Lil-G-Robot/electronics/lil-G-electrical.kicad_pcb

## KiCad design lil-G-electrical.kicad_pcb (2025-05-02)

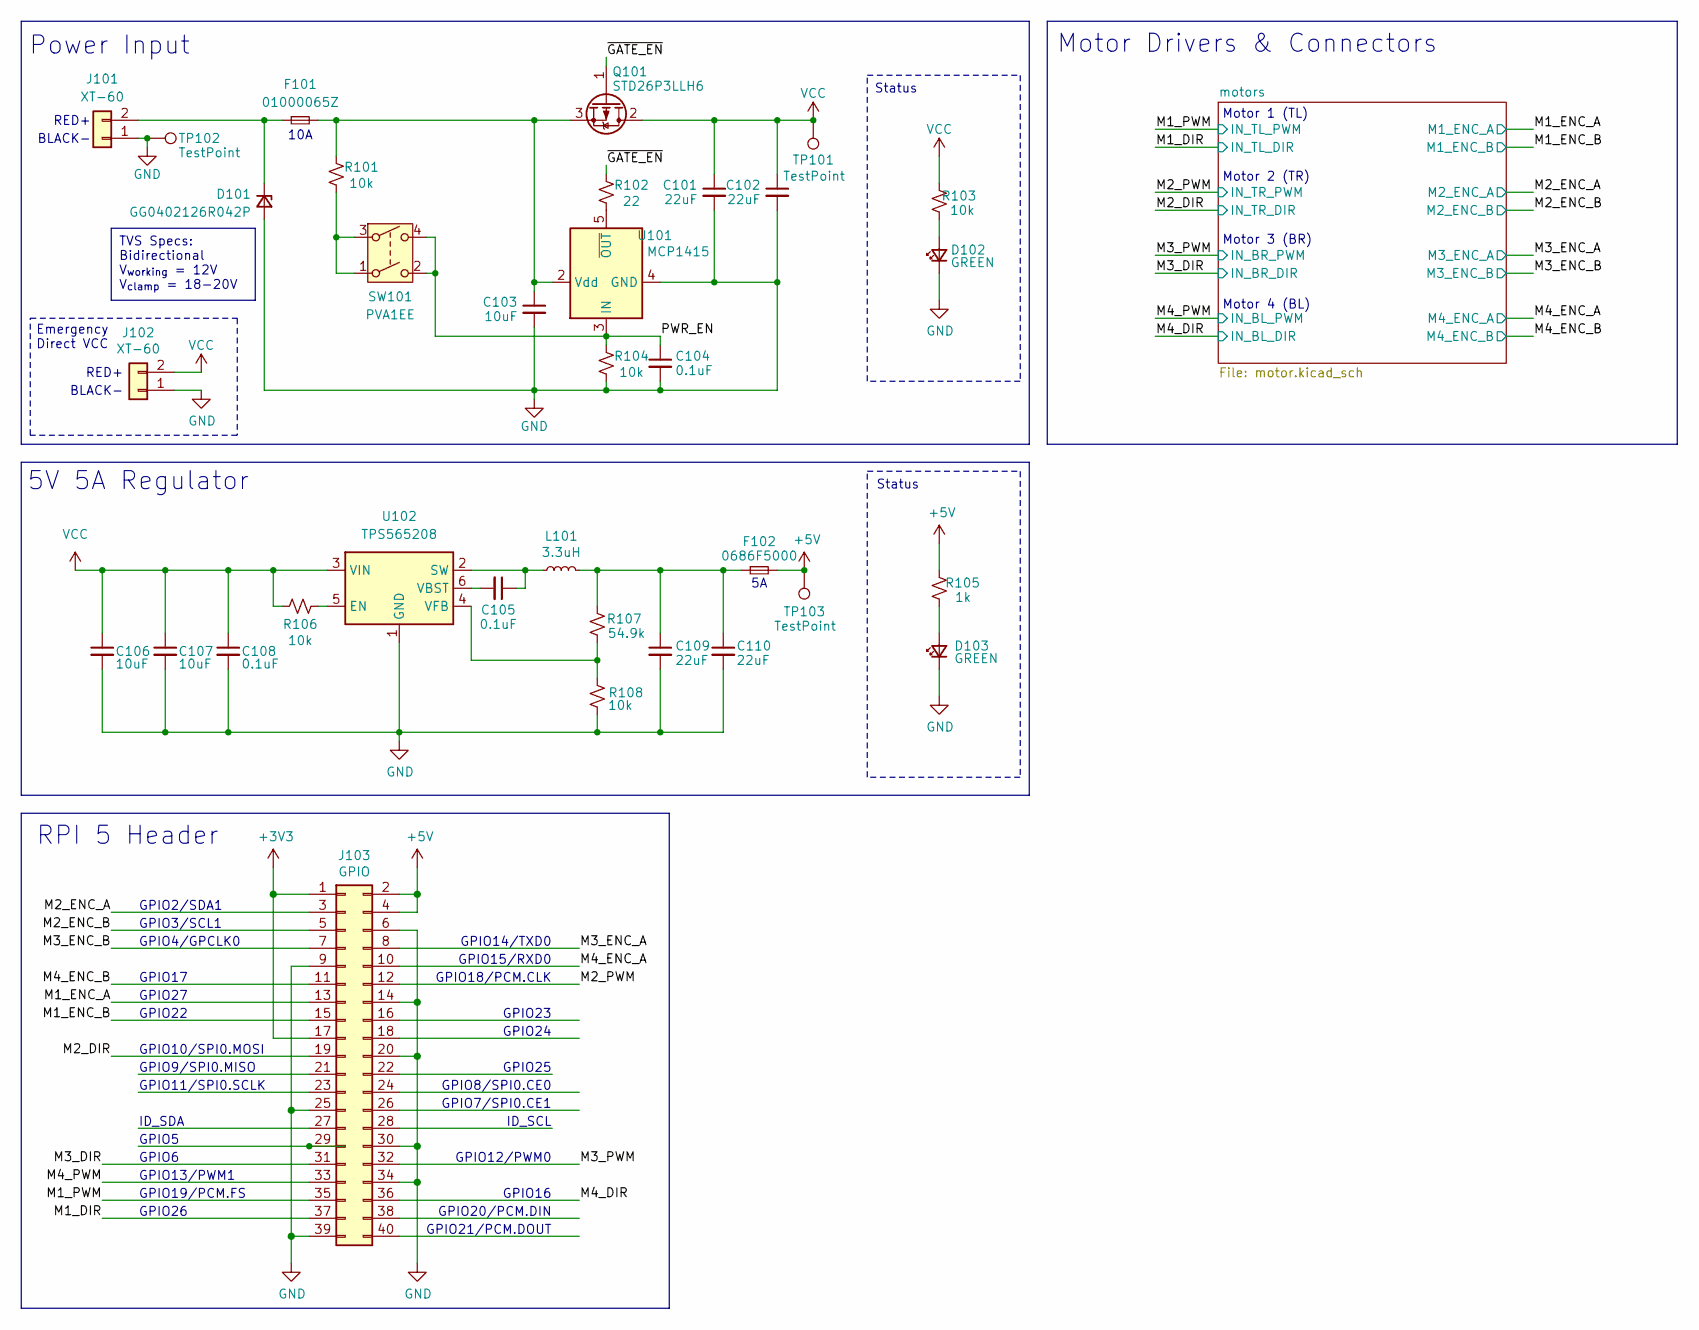
[picture p1: schematic lil-G-electrical.kicad_sch]

Parts:
C101, C102, C109, C110: 22uF; C_0805_2012Metric
C103, C106, C107: 10uF; C_0603_1608Metric
C104, C105, C108: 0.1uF; C_0603_1608Metric
D101: GG0402126R042P; D_0402_1005Metric
D102, D103: GREEN; LED_0603_1608Metric
F101: 01000065Z; LittleFuse_Mini_100_SMD
F102: 0686F5000; Fuse_0603_1608Metric; MPN F0603SB5000V032TM
J101, J102: XT-60; AMASS_XT60-M_1x02_P7.20mm_Vertical
J103: GPIO; PinSocket_2x20_P2.54mm_Vertical
L101: 3.3uH; L_Bourns_SRP5030T; MPN SRP5030T-3R3M
Q101: STD26P3LLH6; TO-252-2
R101, R103, R104, R106, R108: 10k; R_0603_1608Metric
R102: 22; R_0603_1608Metric
R105: 1k; R_0603_1608Metric
R107: 54.9k; R_0603_1608Metric
SW101: PVA1EE; SW_Push_2P1T_Toggle_CK_PVA1xxH4xxxxxxV2
TP101, TP102, TP103: TestPoint; TestPoint_Keystone_5000-5004_Miniature
U101: MCP1415; SOT-23-5
U102: TPS565208; SOT-23-6

Connections:
+3V3: J103.1, J103.17; also elsewhere on the board
+5V: F102.2, J103.2, J103.4, R105.2, TP103.1; also elsewhere on the board
/M1_DIR: J103.37; also elsewhere on the board
/M1_ENC_A: J103.13; also elsewhere on the board
/M1_ENC_B: J103.15; also elsewhere on the board
/M1_PWM: J103.35; also elsewhere on the board
/M2_DIR: J103.19; also elsewhere on the board
/M2_ENC_A: J103.3; also elsewhere on the board
/M2_ENC_B: J103.5; also elsewhere on the board
/M2_PWM: J103.12; also elsewhere on the board
/M3_DIR: J103.31; also elsewhere on the board
/M3_ENC_A: J103.8; also elsewhere on the board
/M3_ENC_B: J103.7; also elsewhere on the board
/M3_PWM: J103.32; also elsewhere on the board
/M4_DIR: J103.36; also elsewhere on the board
/M4_ENC_A: J103.10; also elsewhere on the board
/M4_ENC_B: J103.11; also elsewhere on the board
/M4_PWM: J103.33; also elsewhere on the board
/PWR_EN: C104.1, R104.1, SW101.2, SW101.4, U101.3 (IN)
GND: C101.2, C102.2, C103.2, C104.2, C106.2, C107.2, C108.2, C109.2, C110.2, D101.2 (A), D102.1 (K), D103.1 (K), J101.1, J102.1, J103.6, J103.9, J103.14, J103.20, J103.25, J103.30, J103.34, J103.39, R104.2, R108.1, TP102.1, U101.4 (GND), U102.1 (GND); also elsewhere on the board
unnamed: C109.1, C110.1, F102.1, L101.2, R107.2
unnamed: D101.1 (K), F101.1, J101.2
unnamed: D102.2 (A), R103.1
unnamed: D103.2 (A), R105.1
unnamed: Q101.1 (G), R102.1
unnamed: R101.2, SW101.1, SW101.3
unnamed: R102.2, U101.5 (~OUT)
unnamed: R106.1, U102.5 (EN)
unnamed: C105.1, L101.1, U102.2 (SW)
unnamed: C105.2, U102.6 (VBST)
unnamed: R107.1, R108.2, U102.4 (VFB)

Notes on the sheet:
TVS Specs: Bidirectional V_{working} = 12V V_{clamp} = 18-20V
GPIO25
GPIO17
Status
Motor 3 (BR)
GPIO4/GPCLK0
5V 5A Regulator
BLACK-
GPIO11/SPI0.SCLK
GPIO27
Motor 1 (TL)
ID_SCL
GPIO18/PCM.CLK
GPIO16
GPIO19/PCM.FS
GPIO21/PCM.DOUT
GPIO24
GPIO6
Motor 2 (TR)
GPIO22
GPIO12/PWM0
GPIO5
GPIO2/SDA1
Motor 4 (BL)
GPIO7/SPI0.CE1
Motor Drivers & Connectors
GPIO23
GPIO3/SCL1
GPIO20/PCM.DIN
Power Input
GPIO26
GPIO9/SPI0.MISO
10A
GPIO14/TXD0
RED+
GPIO10/SPI0.MOSI
RPI 5 Header
GPIO15/RXD0
ID_SDA
GPIO13/PWM1
GPIO8/SPI0.CE0
Emergency Direct VCC

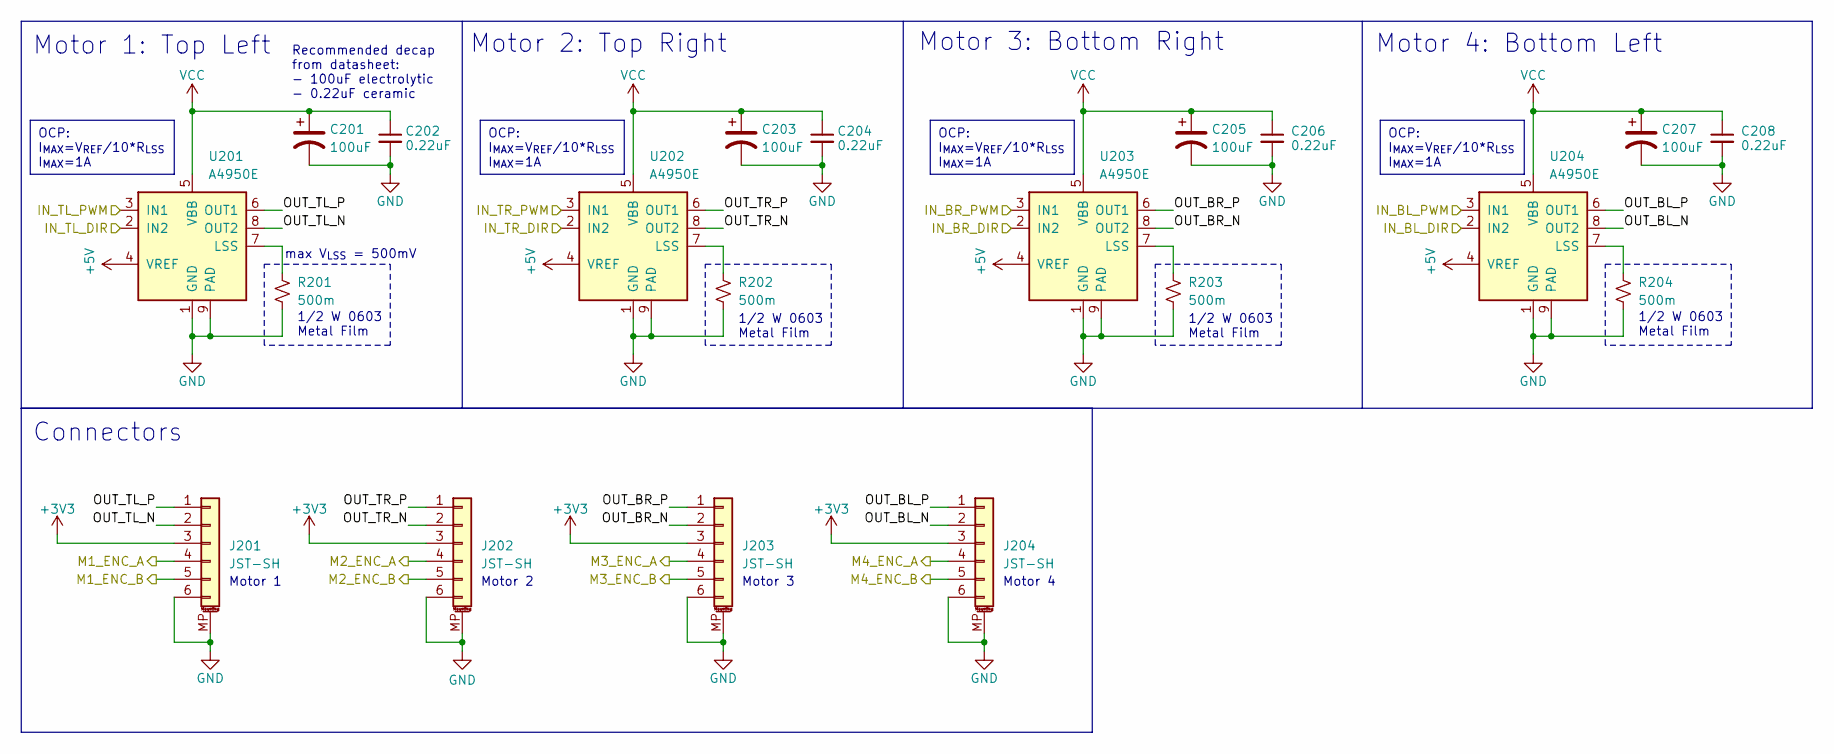
[picture p2: schematic motor.kicad_sch]

Parts:
C201, C203, C205, C207: 100uF; CP_Elec_6.3x7.7
C202, C204, C206, C208: 0.22uF; C_0603_1608Metric
J201, J202, J203, J204: JST-SH; JST_SH_SM06B-SRSS-TB_1x06-1MP_P1.00mm_Horizontal
R201, R202, R203, R204: 500m; R_0603_1608Metric
U201, U202, U203, U204: A4950E; SOIC-8-1EP_3.9x4.9mm_P1.27mm_EP2.41x3.3mm_ThermalVias

Connections:
+3V3: J201.3, J202.3, J203.3, J204.3; also elsewhere on the board
+5V: U201.4 (VREF), U202.4 (VREF), U203.4 (VREF), U204.4 (VREF); also elsewhere on the board
/M1_DIR: U201.2 (IN2); also elsewhere on the board
/M1_ENC_A: J201.4; also elsewhere on the board
/M1_ENC_B: J201.5; also elsewhere on the board
/M1_PWM: U201.3 (IN1); also elsewhere on the board
/M2_DIR: U202.2 (IN2); also elsewhere on the board
/M2_ENC_A: J202.4; also elsewhere on the board
/M2_ENC_B: J202.5; also elsewhere on the board
/M2_PWM: U202.3 (IN1); also elsewhere on the board
/M3_DIR: U203.2 (IN2); also elsewhere on the board
/M3_ENC_A: J203.4; also elsewhere on the board
/M3_ENC_B: J203.5; also elsewhere on the board
/M3_PWM: U203.3 (IN1); also elsewhere on the board
/M4_DIR: U204.2 (IN2); also elsewhere on the board
/M4_ENC_A: J204.4; also elsewhere on the board
/M4_ENC_B: J204.5; also elsewhere on the board
/M4_PWM: U204.3 (IN1); also elsewhere on the board
/motors/OUT_BL_N: J204.2, U204.8 (OUT2)
/motors/OUT_BL_P: J204.1, U204.6 (OUT1)
/motors/OUT_BR_N: J203.2, U203.8 (OUT2)
/motors/OUT_BR_P: J203.1, U203.6 (OUT1)
/motors/OUT_TL_N: J201.2, U201.8 (OUT2)
/motors/OUT_TL_P: J201.1, U201.6 (OUT1)
/motors/OUT_TR_N: J202.2, U202.8 (OUT2)
/motors/OUT_TR_P: J202.1, U202.6 (OUT1)
GND: C201.2, C202.2, C203.2, C204.2, C205.2, C206.2, C207.2, C208.2, J201.6, J201.MP (MountPin), J202.6, J202.MP (MountPin), J203.6, J203.MP (MountPin), J204.6, J204.MP (MountPin), R201.2, R202.2, R203.2, R204.2, U201.1 (GND), U201.9 (PAD), U202.1 (GND), U202.9 (PAD), U203.1 (GND), U203.9 (PAD), U204.1 (GND), U204.9 (PAD); also elsewhere on the board
unnamed: R201.1, U201.7 (LSS)
unnamed: R202.1, U202.7 (LSS)
unnamed: R203.1, U203.7 (LSS)
unnamed: R204.1, U204.7 (LSS)

Notes on the sheet:
OCP: I_{MAX}=V_{REF}/10*R_{LSS} I_{MAX}=1A
Recommended decap from datasheet: - 100uF electrolytic - 0.22uF ceramic
1/2 W 0603 Metal Film
Motor 3: Bottom Right
Motor 4
Motor 3
Connectors
max V_{LSS} = 500mV
Motor 1: Top Left
Motor 2: Top Right
Motor 4: Bottom Left
Motor 1
Motor 2

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
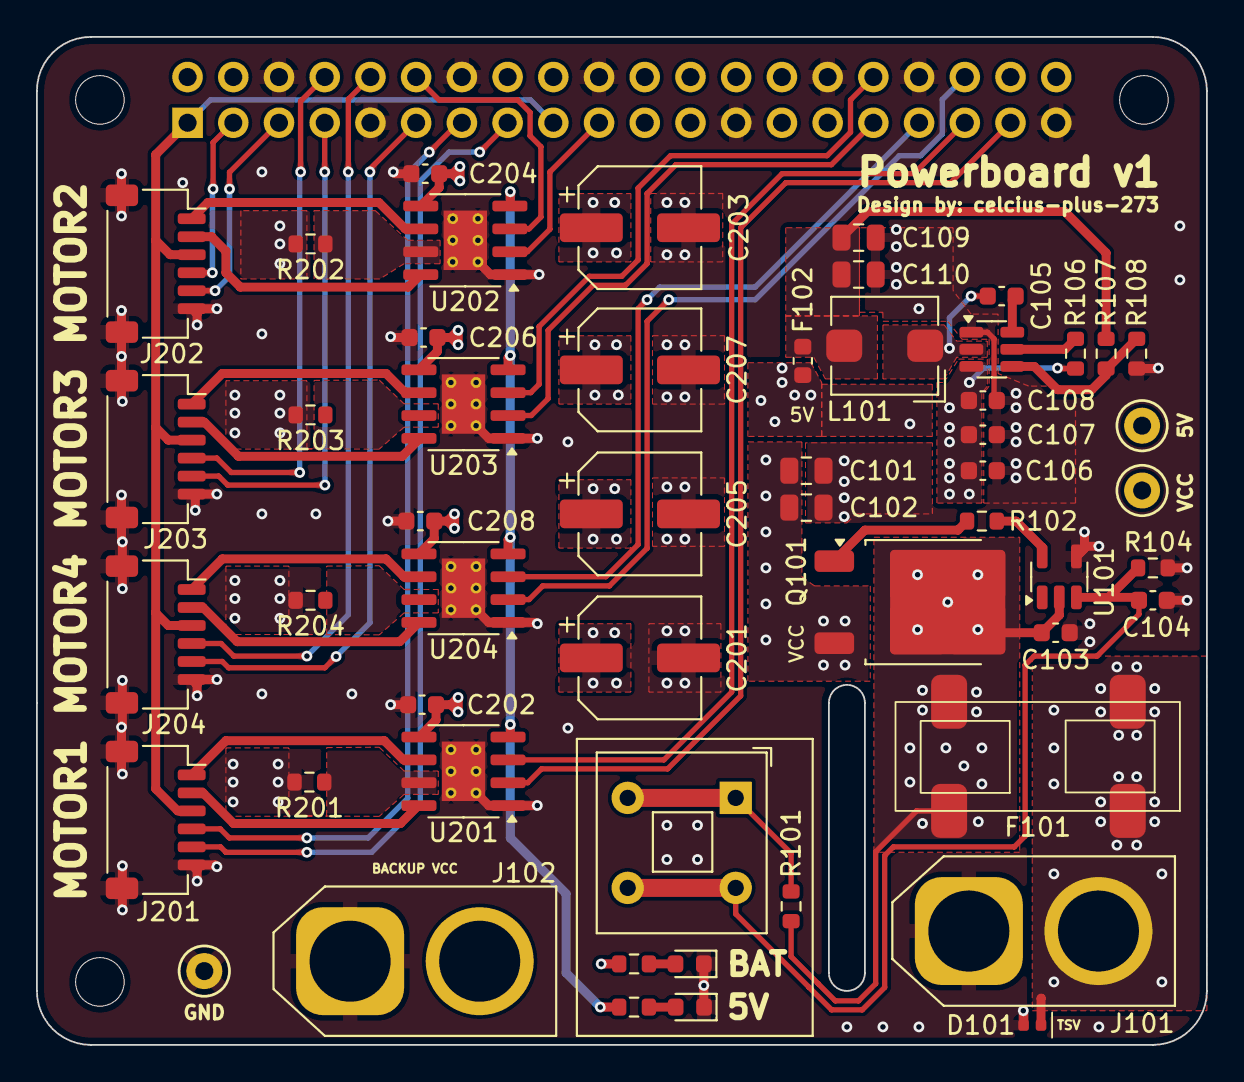
[picture p3: board lil-G-electrical.kicad_pcb from above]

Board: 4 copper layers, 65.0 x 56.0 mm, 57 parts (1 on the bottom side), 45 nets.

Other parts of the board:
MH1, MH2, MH3: MountingHole_2.7mm_M2.5
