Lil-G-Robot/electronics/(commit log)

2025-04-06 power input and regulation almost done
    [lil-G-electrical.kicad_pcb, lil-G-electrical.kicad_sch]
2025-04-07 small update on schematic
    [lil-G-electrical.kicad_sch]
2025-04-13 finished layout of dc drivers and power regulation
    [lil-G-electrical.kicad_pcb, lil-G-electrical.kicad_sch, motor.kicad_sch]
2025-04-29 changed dimension of current sense resistor
    [lil-G-electrical.kicad_pcb, lil-G-electrical.kicad_sch, mcu.kicad_sch, motor.kicad_sch]
2025-05-02 fixed high-side power enable circuit. flipped PMOS source/drain
    [lil-G-electrical.kicad_pcb, lil-G-electrical.kicad_sch, mcu.kicad_sch, motor.kicad_sch]
